pedrolpena/ladcp_interface/ladcp_star_circuit/ladcp_star_circuit.step

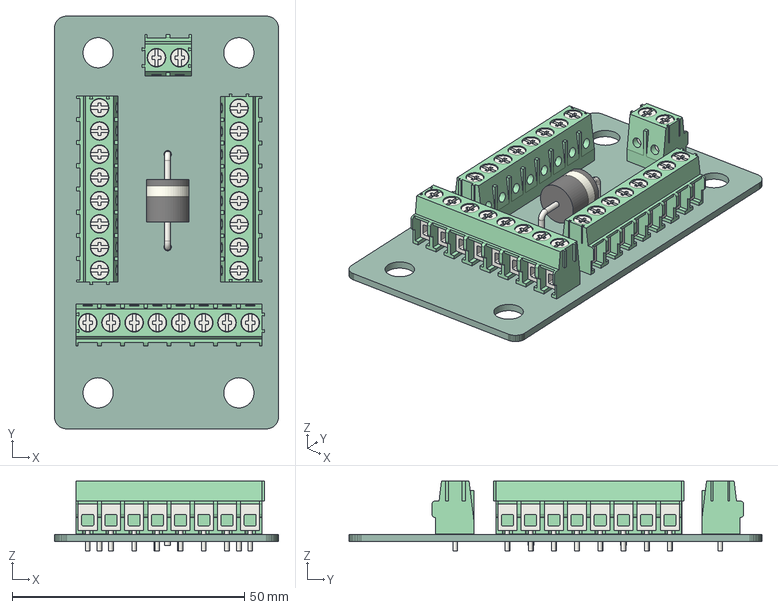
[picture p1: CAD file, 2023-06-27]
ladcp_star_circuit/ladcp_star_circuit.step
48.3 x 88.9 x 15.0 mm
_autosave-ladcp_star_circuit PCB
