pedrolpena/ladcp_interface/(list of files, cad)

Other CAD files:
ladcp_star_circuit/ladcp_star_circuit.dxf
