pedrolpena/ladcp_interface/(list of files, drawings)

Other design files:
ladcp_star_circuit/freerouting.dsn
ladcp_star_circuit/temp-freerouting.dsn
