pedrolpena/ladcp_interface/ladcp_interface_box/ladcp_interface_box/ladcp_interface_box.kicad_pcb

## KiCad design ladcp_interface_box/ladcp_interface_box/ladcp_interface_box.kicad_pcb (2024-03-01)

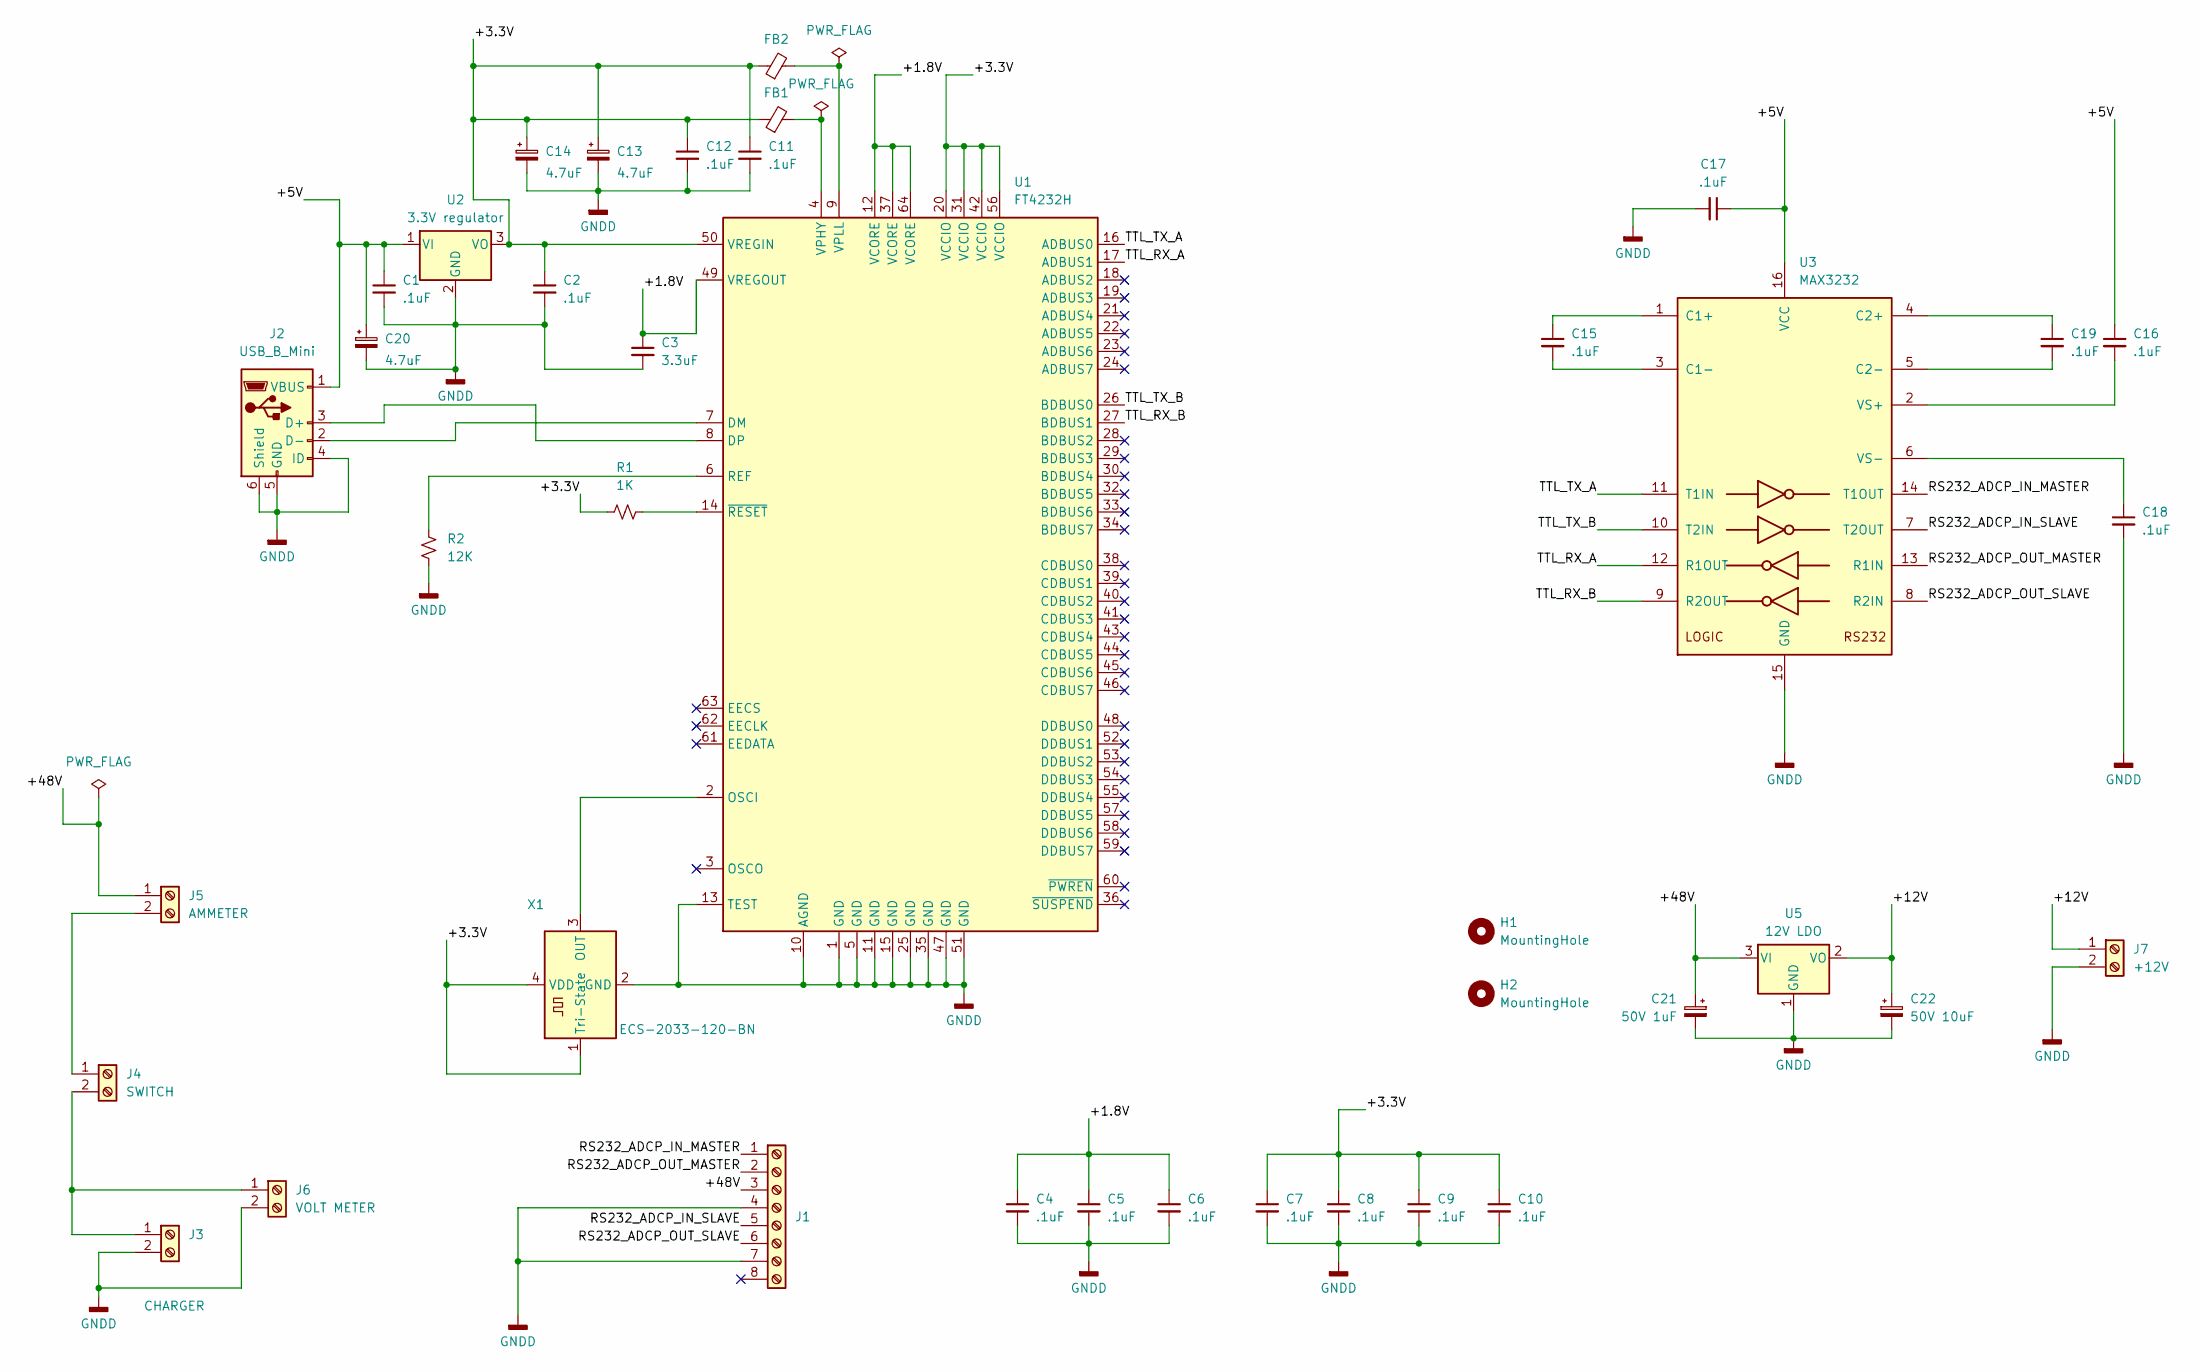
[picture p2: schematic ladcp_interface_box.kicad_sch, LADCP interface box]

Parts:
C1, C2, C4, C5, C6, C7, C8, C9, C10, C11, C12, C15, C16, C17, C18, C19: .1uF; C_0805_2012Metric_Pad1.18x1.45mm_HandSolder; manufacturer part# CC0805KRX7R9BB104
C3: 3.3uF; C_0805_2012Metric_Pad1.18x1.45mm_HandSolder; manufacturer part# CGA4J1X7R1E335K125AC
C13, C14, C20: 4.7uF; CP_EIA-2012-12_Kemet-R_Pad1.30x1.05mm_HandSolder; manufacturer part# TAJR475M010RNJ
C21: 50V 1uF; CP_Radial_D4.0mm_P1.50mm; manufacturer part# 105RSS050M
C22: 50V 10uF; CP_Radial_D6.3mm_P2.50mm; manufacturer part# 106RSS050M
FB1, FB2: FerriteBead_Small; L_0805_2012Metric_Pad1.15x1.40mm_HandSolder; manufacturer part# HZ0805E601R-10
H1, H2: MountingHole; MountingHole_2.1mm
J1: TERM BLK 8POS SIDE ENTRY 5MM PCB; TerminalBlock_Phoenix_PT-1,5-8-5.0-H_1x08_P5.00mm_Horizontal; manufacturer part# 1935226
J2: USB_B_Mini; USB_Mini-B_Wuerth_65100516121_Horizontal; manufacturer part# 65100516121
J3: CHARGER; TerminalBlock_Phoenix_PT-1,5-2-5.0-H_1x02_P5.00mm_Horizontal; manufacturer part# 1935161
J4: SWITCH; TerminalBlock_Phoenix_PT-1,5-2-5.0-H_1x02_P5.00mm_Horizontal; manufacturer part# 1935161
J5: AMMETER; TerminalBlock_Phoenix_PT-1,5-2-5.0-H_1x02_P5.00mm_Horizontal; manufacturer part# 1935161
J6: VOLT METER; TerminalBlock_Phoenix_PT-1,5-2-5.0-H_1x02_P5.00mm_Horizontal; manufacturer part# 1935161
J7: +12V; TerminalBlock_Phoenix_PT-1,5-2-5.0-H_1x02_P5.00mm_Horizontal; manufacturer part# 1935161
R1: 1K; R_0805_2012Metric_Pad1.20x1.40mm_HandSolder; manufacturer part# RC0805FR-071KL
R2: 12K; R_0805_2012Metric_Pad1.20x1.40mm_HandSolder; manufacturer part# RMCF0805JT12K0
U1: FT4232H; LQFP-64_10x10mm_P0.5mm; manufacturer part# FT4232HL-REEL
U2: 3.3V regulator; TO-252-3_TabPin2; manufacturer part# BA033CC0FP-E2
U3: MAX3232; TSSOP-16_4.4x5mm_P0.65mm; manufacturer part# MAX3232EUE+T
U5: 12V LDO; SOT-23; manufacturer part# ZXTR2112FQ-7
X1: ECS-2033-120-BN; Oscillator_SMD_ECS_2520MV-xxx-xx-4Pin_2.5x2.0mm; manufacturer part# ECS-2033-120-BN

Connections:
/+1.8V: C3.1, C4.1, C5.1, C6.1, U1.12 (VCORE), U1.37 (VCORE), U1.49 (VREGOUT), U1.64 (VCORE)
/+3.3V: C2.1, C7.1, C8.1, C9.1, C10.1, C11.1, C12.1, C13.1, C14.1, FB1.1, FB2.1, R1.2, U1.20 (VCCIO), U1.31 (VCCIO), U1.42 (VCCIO), U1.50 (VREGIN), U1.56 (VCCIO), U2.3 (VO), X1.1 (Tri-State), X1.4 (VDD)
/+5V: C1.1, C16.1, C17.1, C20.1, J2.1 (VBUS), U2.1 (VI), U3.16 (VCC)
/+12V: C22.1, J7.1, U5.2 (VO)
/+48V: C21.1, J1.3, J5.1, U5.3 (VI)
/RS232_ADCP_IN_MASTER: J1.1, U3.14 (T1OUT)
/RS232_ADCP_IN_SLAVE: J1.5, U3.7 (T2OUT)
/RS232_ADCP_OUT_MASTER: J1.2, U3.13 (R1IN)
/RS232_ADCP_OUT_SLAVE: J1.6, U3.8 (R2IN)
/TTL_RX_A: U1.17 (ADBUS1), U3.12 (R1OUT)
/TTL_RX_B: U1.27 (BDBUS1), U3.9 (R2OUT)
/TTL_TX_A: U1.16 (ADBUS0), U3.11 (T1IN)
/TTL_TX_B: U1.26 (BDBUS0), U3.10 (T2IN)
GNDD: C1.2, C2.2, C3.2, C4.2, C5.2, C6.2, C7.2, C8.2, C9.2, C10.2, C11.2, C12.2, C13.2, C14.2, C17.2, C18.2, C20.2, C21.2, C22.2, J1.4, J1.7, J2.4 (ID), J2.5 (GND), J2.6 (Shield), J3.2, J6.2, J7.2, R2.2, U1.1 (GND), U1.5 (GND), U1.10 (AGND), U1.11 (GND), U1.13 (TEST), U1.15 (GND), U1.25 (GND), U1.35 (GND), U1.47 (GND), U1.51 (GND), U2.2 (GND), U3.15 (GND), U5.1 (GND), X1.2 (GND)
unnamed: J2.3 (D+), U1.8 (DP)
unnamed: J2.2 (D-), U1.7 (DM)
unnamed: J3.1, J4.2, J6.1
unnamed: J4.1, J5.2
unnamed: U1.2 (OSCI), X1.3 (OUT)
unnamed: R2.1, U1.6 (REF)
unnamed: FB1.2, U1.4 (VPHY)
unnamed: FB2.2, U1.9 (VPLL)
unnamed: R1.1, U1.14 (~RESET)
unnamed: C15.1, U3.1 (C1+)
unnamed: C15.2, U3.3 (C1-)
unnamed: C19.1, U3.4 (C2+)
unnamed: C19.2, U3.5 (C2-)
unnamed: C16.2, U3.2 (VS+)
unnamed: C18.1, U3.6 (VS-)

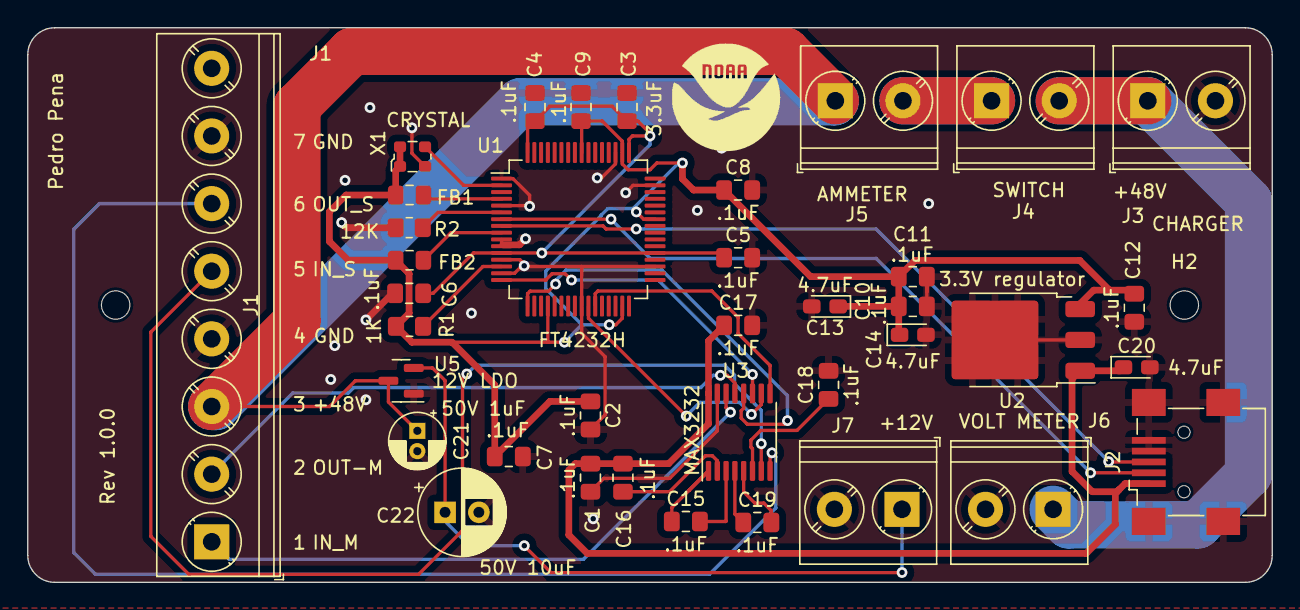
[picture p3: board ladcp_interface_box.kicad_pcb from above]

Board: 2 copper layers, 92.0 x 41.0 mm, 40 parts (0 on the bottom side), 29 nets.
