pedrolpena/ladcp_interface/ladcp_star_circuit/ladcp_star_circuit.kicad_pcb

## KiCad design ladcp_star_circuit/ladcp_star_circuit.kicad_pcb (2024-03-01)

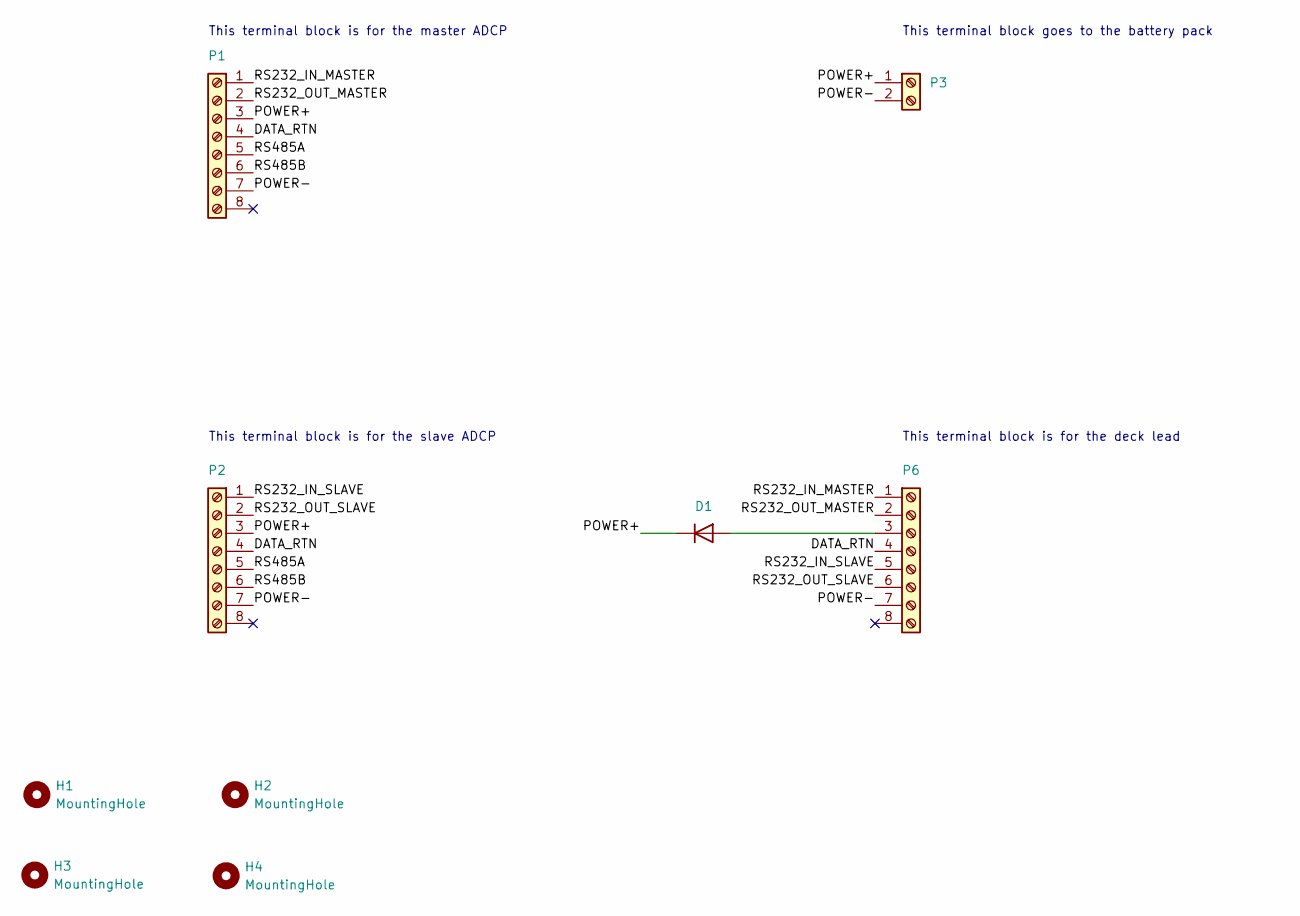
[picture p4: schematic ladcp_star_circuit.kicad_sch, LADCP Star Board]

Parts:
D1: P600G-E3/54; D_P600_R-6_P20.00mm_Horizontal; manufacturer part# P600G-E3/54
H1, H2, H3, H4: MountingHole; MountingHole_6.5mm
P1, P2, P6: TERM BLK 8POS SIDE ENTRY 5MM PCB; TerminalBlock_Phoenix_PT-1,5-8-5.0-H_1x08_P5.00mm_Horizontal; manufacturer part# 1935226
P3: TERM BLK 2POS SIDE ENTRY 5MM PCB; TerminalBlock_Phoenix_PT-1,5-2-5.0-H_1x02_P5.00mm_Horizontal; manufacturer part# 1935161

Connections:
/DATA_RTN: P1.4, P2.4, P6.4
/POWER+: D1.1 (K), P1.3, P2.3, P3.1
/POWER-: P1.7, P2.7, P3.2, P6.7
/RS232_IN_MASTER: P1.1, P6.1
/RS232_IN_SLAVE: P2.1, P6.5
/RS232_OUT_MASTER: P1.2, P6.2
/RS232_OUT_SLAVE: P2.2, P6.6
/RS485A: P1.5, P2.5
/RS485B: P1.6, P2.6
unnamed: D1.2 (A), P6.3

Notes on the sheet:
This terminal block is for the deck lead
This terminal block goes to the battery pack
This terminal block is for the slave ADCP
This terminal block is for the master ADCP

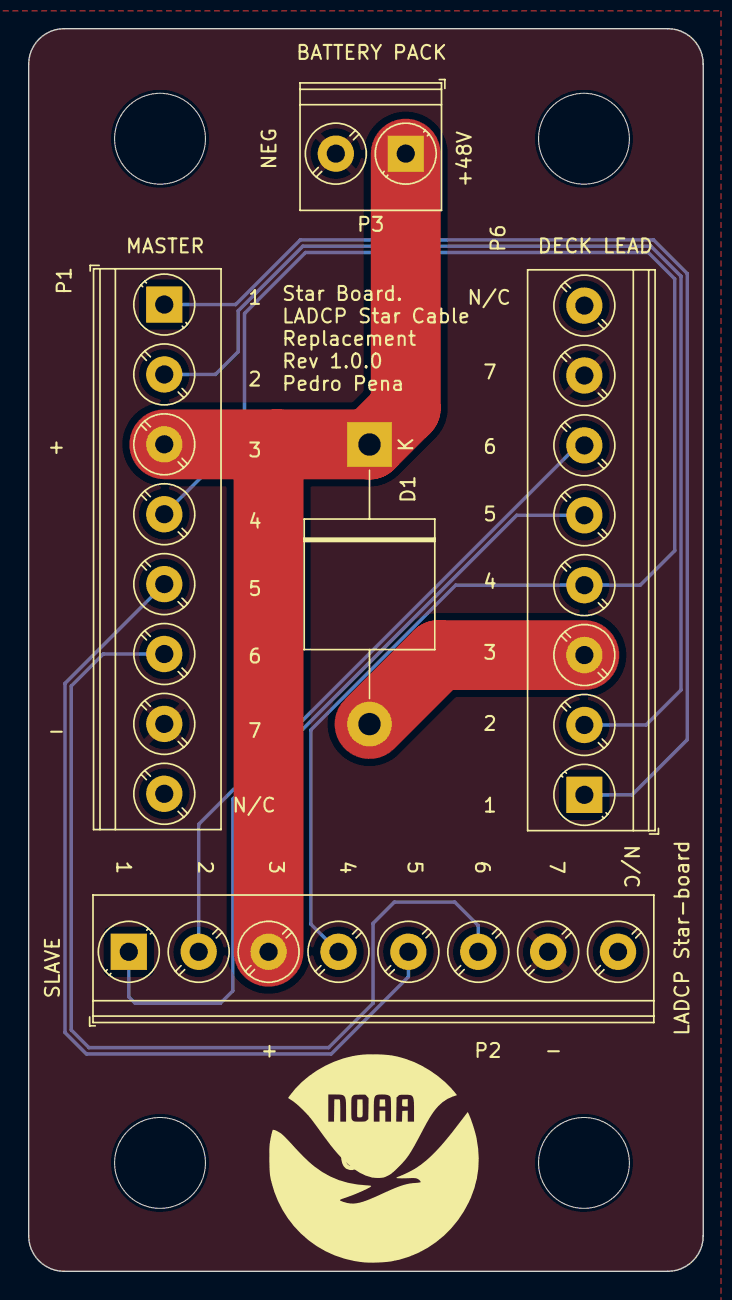
[picture p5: board ladcp_star_circuit.kicad_pcb from above]

Board: 2 copper layers, 48.3 x 88.9 mm, 9 parts (0 on the bottom side), 10 nets.
