pedrolpena/ladcp_interface/(commit log)

2023-06-29 updated files
    [ladcp_interface_box.kicad_sch]
2023-06-30 added PCB design
    [ladcp_interface_box.kicad_pcb, ladcp_interface_box.kicad_sch]
2023-07-06 fixed errors
    [ladcp_interface_box.kicad_pcb]
2023-07-07 removed pcb errors and warnings
2023-10-16 finished circuit
    [ladcp_interface_box-B_Cu.gbr, ladcp_interface_box-B_Mask.gbr, ladcp_interface_box-B_Paste.gbr, ladcp_interface_box-B_Silkscreen.gbr, ladcp_interface_box-Edge_Cuts.gbr, ladcp_interface_box-F_Cu.gbr, ladcp_interface_box-F_Mask.gbr, ladcp_interface_box-F_Paste.gbr]
2024-03-01 added final changes
    [ladcp_interface_box-B_Cu.gbr, ladcp_interface_box-B_Mask.gbr, ladcp_interface_box-B_Paste.gbr, ladcp_interface_box-B_Silkscreen.gbr, ladcp_interface_box-Edge_Cuts.gbr, ladcp_interface_box-F_Cu.gbr, ladcp_interface_box-F_Mask.gbr, ladcp_interface_box-F_Paste.gbr]
